emilecantin/ha-eink-calendar/docs/screenshots/Capture d’écran, le 2026-01-17 à 15.30.16.png

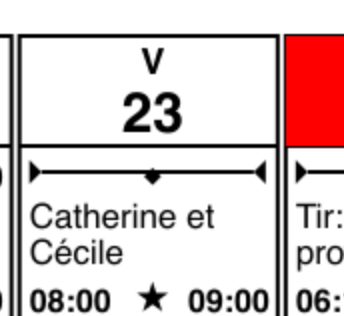
docs/screenshots/Capture d’écran, le 2026-01-17 à 15.30.16.png
