emilecantin/ha-eink-calendar/hardware/battery-carrier/board-top.png

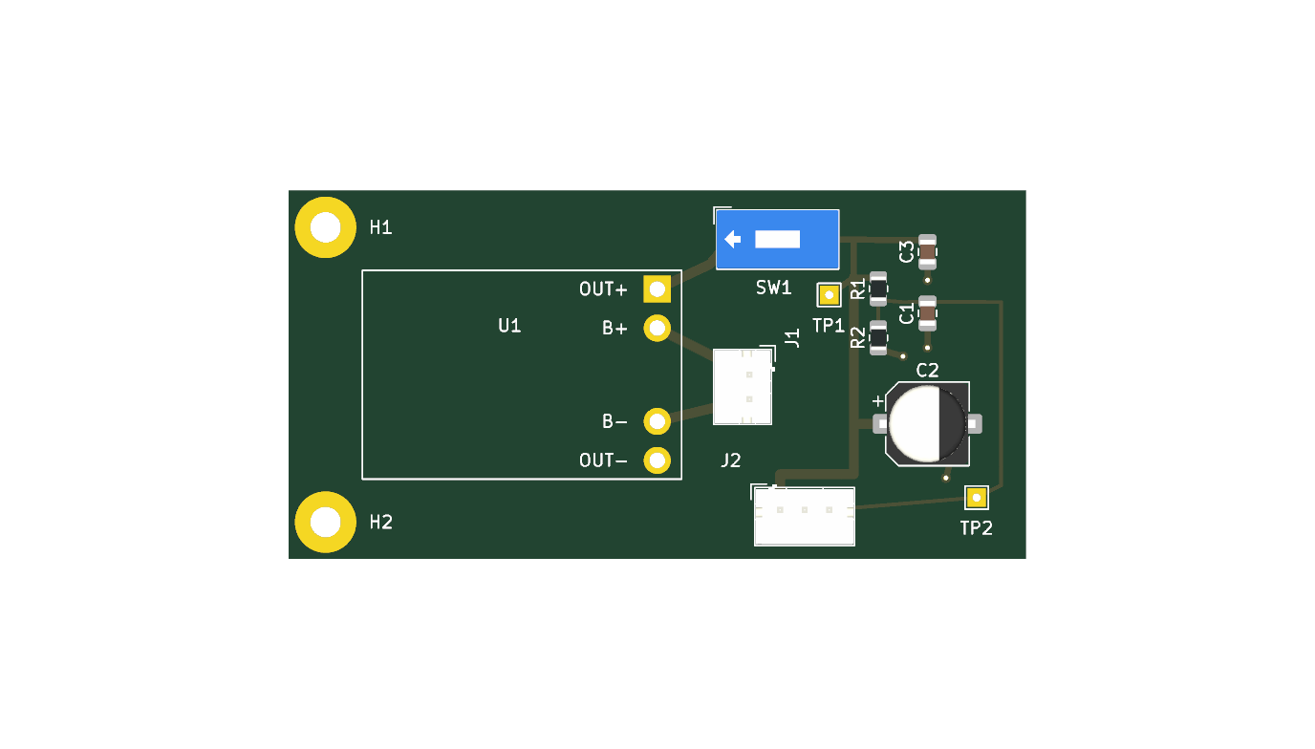
hardware/battery-carrier/board-top.png
