emilecantin/ha-eink-calendar/hardware/battery-carrier/bom.csv

Reference | Value | Footprint
C1 | 100nF | Capacitor_SMD:C_0805_2012Metric
C2 | 220uF 10V | Capacitor_SMD:CP_Elec_6.3x3.9
C3 | 10uF | Capacitor_SMD:C_0805_2012Metric
J1 | 18650 | Connector_JST:JST_PH_B2B-PH-K_1x02_P2.00mm_Vertical
J2 | to ESP32 | Connector_JST:JST_PH_B3B-PH-K_1x03_P2.00mm_Vertical
R1,R2 | 100k 1% | Resistor_SMD:R_0805_2012Metric
SW1 | SPST | Button_Switch_THT:SW_DIP_SPSTx01_Slide_9.78x4.72mm_W7.62mm_P2.54mm
U1 | TP4056 module | epcal:TP4056_Module_03962A
