emilecantin/ha-eink-calendar/hardware/battery-carrier/battery-carrier.kicad_pcb

## KiCad design hardware/battery-carrier/battery-carrier.kicad_pcb (2026-08-29)

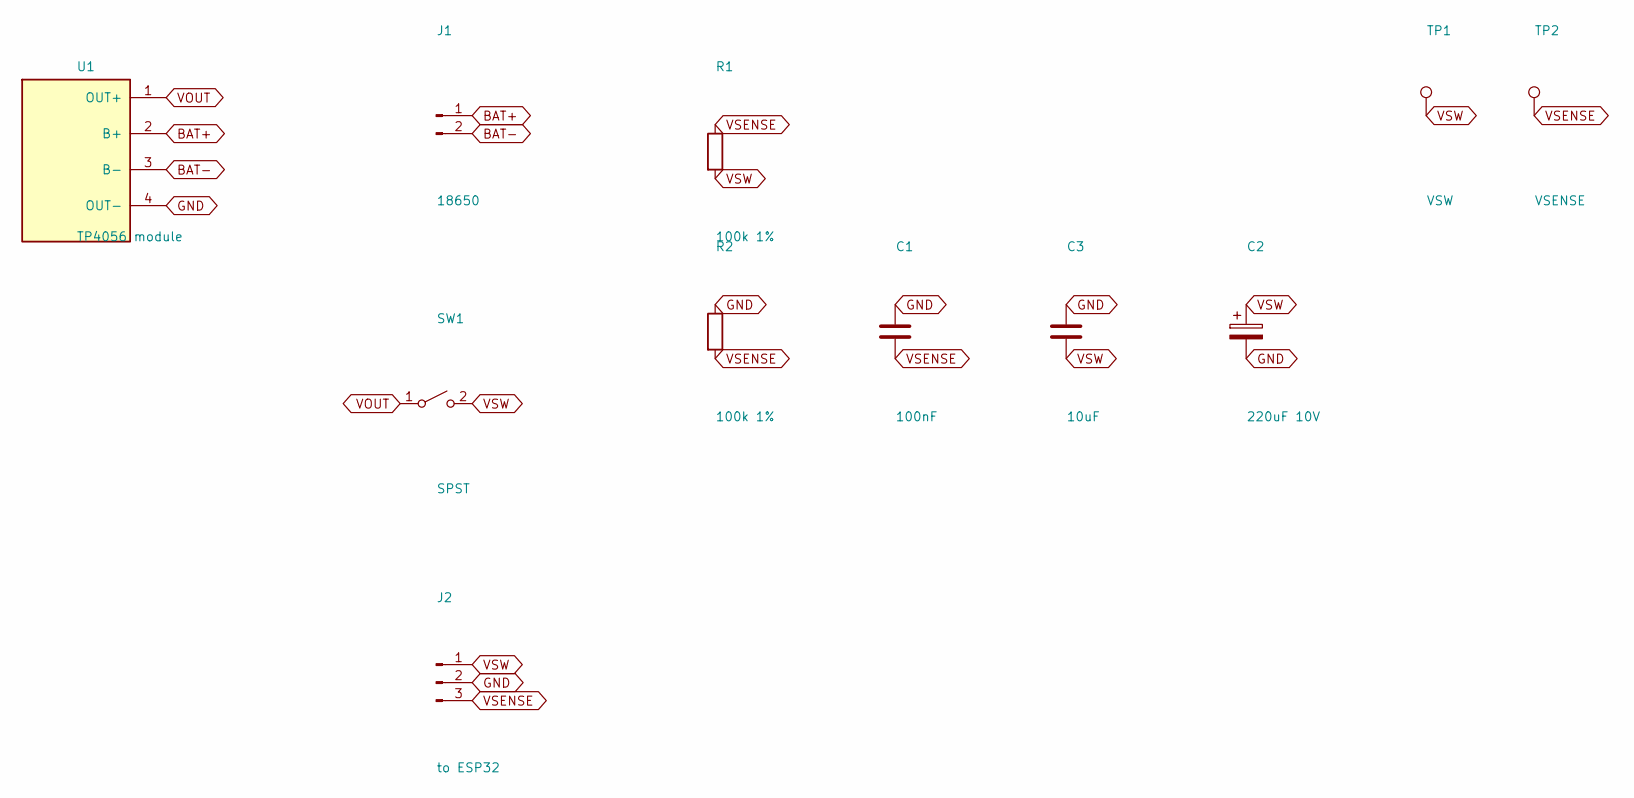
[picture p4: schematic battery-carrier.kicad_sch]

Parts:
C1: 100nF; C_0805_2012Metric
C2: 220uF 10V; CP_Elec_6.3x3.9
C3: 10uF; C_0805_2012Metric
J1: 18650; JST_PH_B2B-PH-K_1x02_P2.00mm_Vertical
J2: to ESP32; JST_PH_B3B-PH-K_1x03_P2.00mm_Vertical
R1, R2: 100k 1%; R_0805_2012Metric
SW1: SPST; SW_DIP_SPSTx01_Slide_9.78x4.72mm_W7.62mm_P2.54mm
TP1: VSW; TestPoint_THTPad_1.5x1.5mm_Drill0.7mm
TP2: VSENSE; TestPoint_THTPad_1.5x1.5mm_Drill0.7mm
U1: TP4056 module; TP4056_Module_03962A

Connections:
BAT+: J1.1, U1.2 (B+)
BAT-: J1.2, U1.3 (B-)
GND: C1.1, C2.2, C3.1, J2.2, R2.1, U1.4 (OUT-)
VOUT: SW1.1 (A), U1.1 (OUT+)
VSENSE: C1.2, J2.3, R1.1, R2.2, TP2.1
VSW: C2.1, C3.2, J2.1, R1.2, SW1.2 (B), TP1.1

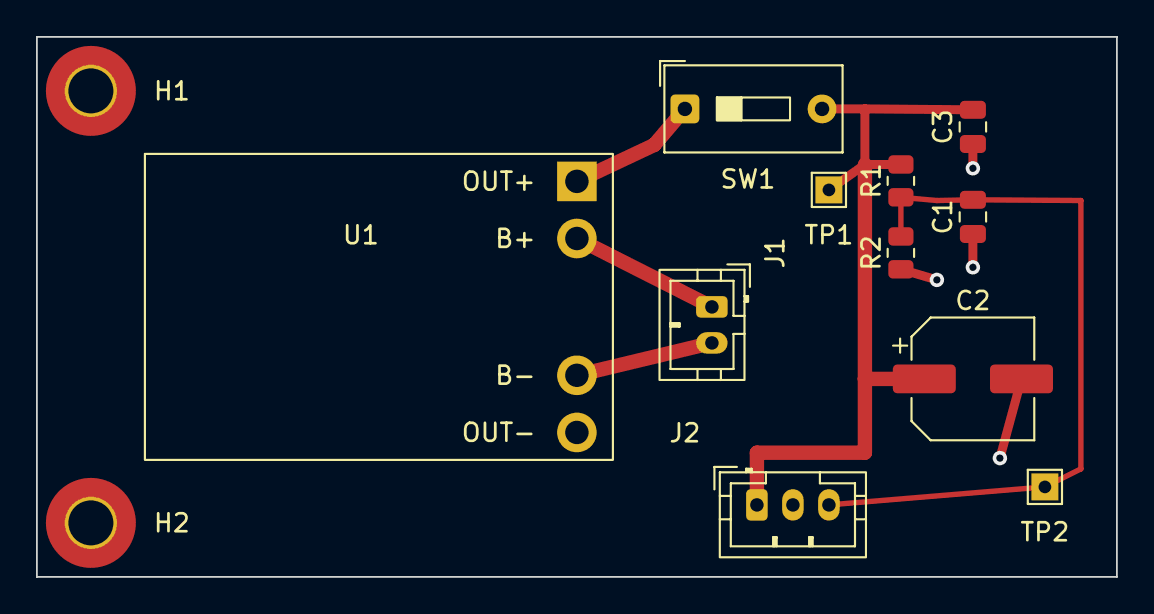
[picture p5: board battery-carrier.kicad_pcb from above]

Board: 2 copper layers, 60.0 x 30.0 mm, 13 parts (0 on the bottom side), 6 nets.

Other parts of the board:
H1, H2: MountingHole_2.5mm_Pad_TopBottom
