emilecantin/ha-eink-calendar/(commit log)

2026-01-18 Initial commit: EPCAL e-paper calendar display
    Features:
    - Node.js server with Home Assistant calendar integration
    - Weather forecast display in headers
    - Canvas-based rendering with Inter font
    - ETag-based caching for battery efficiency
    - ESP32 firmware with WiFiManager for easy setup
    - Pre-rendered QR code setup screen
    - Deep sleep with configurable refresh interval
2026-01-18 Remove old Arduino test files from root folder
    These files were leftovers from early testing, replaced by the
    PlatformIO project structure in Arduino/epcal/.
    [epcal.ino]
2026-01-18 Add Docker support for server deployment
    - Dockerfile with canvas dependencies (cairo, pango)
    - docker-compose.yml with config volume mount
    - Support CONFIG_PATH env var for config file location
    - Update README with Docker setup instructions
    - Add .dockerignore for lean builds
2026-01-18 Add emoji font support to Docker image
    Install fonts-noto-color-emoji for weather icons (☀, ⛅, 🌧, ❄).
2026-01-18 Fix weather icons in Docker: use Symbola font
    - Replace emoji (🌧, 🌫, 💨) with standard Unicode symbols
    - Use Symbola + DejaVu fonts instead of Inter for weather icons
    - Install fonts-symbola and fonts-dejavu-core in Docker image
    Inter font doesn't include weather symbols; Symbola does.
2026-01-19 Add battery testing section to TODO and hardware link to README
    - Added Hardware / Battery Testing section to TODO.md with tasks for
    measuring deep sleep current and optimizing power consumption
    - Added link to Waveshare ESP32 Driver Board wiki in README.md
2026-01-21 Unify event filtering logic across all calendar sections
    Extract common event filtering logic into getEventsForDay() function that:
    - Filters events for a specific day (events starting OR spanning that day)
    - Returns EventForDay objects with startsOnDay/endsOnDay indicators
    Apply this consistently to all sections:
    - Landscape Today section
    - Landscape 6-day section
    - Portrait Today section
    - Portrait Week section
    This ensures multi-day events are displayed correctly in all sections
    with proper start/end markers showing which day they begin and end on.
2026-01-21 Enhance renderer tests with comprehensive coverage
    - Added 6 new test cases for extractChunk function
    - Test all-black and all-white bitmaps
    - Test memory/performance characteristics (zero-copy views)
    - Test ESP32 integration workflow
    - Verify chunk sizes fit ESP32 memory constraints
    - Test horizontal display splitting for proper rendering
    - Total: 15 tests for extractChunk (up from 9)
    - All 86 tests passing across 6 test suites
    - Renderer coverage remains at 4.54% (testing exported functions only)
2026-01-21 Export renderer helper functions for testing
    - Export 8 helper functions from renderer.ts for unit testing:
    - getIconCenterOffset, getIconBottomOffset (icon positioning)
    - getWeatherIcon (weather condition mapping)
    - formatTime (time formatting)
    - truncateText, wrapText (text layout)
    - rotateImageData90CW (image rotation for portrait mode)
    - imageDataTo1Bit (critical bitmap conversion logic)
    - Add comprehensive test suite (43 tests) for newly exported functions:
    - Icon positioning calculations
    - Weather icon mapping with case-insensitivity
    - Time formatting in HH:mm format
    - Text truncation and wrapping with canvas measurement
    - Image rotation (90° clockwise for portr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
2026-01-22 Refactor server rendering code into modular architecture
    - Extract utilities into focused modules:
    - text-utils.ts: Text formatting (truncate, wrap, capitalize, formatTime)
    - weather-utils.ts: Weather icons and forecast handling
    - icon-utils.ts: Collection icon loading, caching, and positioning
    - event-filters.ts: Event filtering and collection icon matching
    - bitmap-utils.ts: Image rotation, 1-bit conversion, chunk extraction
    - font-config.ts: Font registration
    - Create section-renderers directory with dedicated renderers:
    - indicators.ts: Binary sensor indicator bars
    - portrait-today.ts, portrait-week.ts, portrait-upcoming.ts
    - landscape-today.ts, landscape-week.ts, land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
2026-01-28 Add Home Assistant custom component with Python renderer
    - Complete EPCAL integration for Home Assistant
    - Python renderer matching TypeScript output pixel-perfect
    - Support for both portrait and landscape orientations
    - Calendar event rendering with icons, all-day events, multi-day events
    - Weather integration with forecast display
    - Waste collection calendar support
    - Modular section renderers (today, upcoming, week, indicators)
    - Comprehensive test suite with visual regression testing
    - Type checking with Pyright (0 errors, 0 warnings)
    - HTTP endpoints for e-paper display integration
    - Config flow for easy setup in HA UI
2026-01-28 Add Home Assistant test environment to docker-compose
    - Add homeassistant service for integration development
    - Mount custom_components/epcal and ha-test-config
    - Move legacy server to 'legacy' profile (docker-compose --profile legacy up)
    - Add healthcheck for HA service
    - Configure timezone and host network mode
2026-01-28 Update .gitignore for development artifacts
    - Ignore server/epcal-config.json (local config)
    - Ignore server/__tests__/*.js (test files)
    - Ignore server/icons_svg_cache/ (downloaded icons)
    - Ignore Arduino/epcal/setup_screen_preview.png (generated preview)
2026-03-24 Improve ESP32 reliability with watchdog, timeouts, and error display
    - Add hardware watchdog timer (120s) to auto-reboot on hangs
    - Add 10s stall timeout to HTTP download loop
    - Fix DEV_ModuleInit() missing in display_show_error/display_show_message
    - Show error messages on e-paper display for WiFi/HTTP/download failures
    - Clear ETag cache after WiFi reconfiguration to force display refresh
    - Show setup screen when WiFi connection fails (with QR codes)
    - Increase WiFi retries to 5 with 10s timeout per attempt
    - Unify setup screen fonts (all monospaced via Paint library)
    - Add -Wno-error=return-type for Waveshare library build fix
    [display.cpp, epcal.ino, http_client.cpp]
2026-03-24 Rename epcal → eink_calendar and add HA-native device discovery
    Rename the HA domain from epcal to eink_calendar and refactor the
    device setup flow so ESP32s are discovered natively in Home Assistant.
    Directory rename:
    - custom_components/epcal/ → custom_components/eink_calendar/
    - All class names: Epcal* → EinkCalendar*
    - All URLs: /api/epcal/ → /api/eink_calendar/
    - Display names: "EPCAL" → "E-Ink Calendar"
    New device discovery architecture:
    - ESP32 discovers HA via mDNS (_home-assistant._tcp)
    - POST /api/eink_calendar/announce triggers config_entries discovery flow
    - "Discovered" card appears in Settings → Integrations
    - User configures calendars/weather/layout in the config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
2026-03-24 Register announce endpoint at integration load time
    The HTTP views were only registered when a config entry existed,
    meaning the announce endpoint returned 404 for new devices with
    no config entries yet. Now registers views in async_setup() which
    runs when the integration loads, before any config entries.
    Also fix display_sleep() GPIO errors by re-initializing pins.
    [display.cpp]
2026-03-24 Add zeroconf discovery for automatic HA integration loading
    The integration wasn't loading because HA only loads integrations
    that have config entries. Now the ESP32 advertises a _eink-calendar._tcp
    mDNS service, and HA's zeroconf auto-discovers it, loading the
    integration and registering the announce endpoint automatically.
2026-03-24 Fix bitmap inversion, mDNS timing, and config flow title
    - bitmap_utils: Fix inverted bit logic (0=colored, 1=white per e-paper spec)
    - bitmap_utils: Fix thresholds to match Node.js reference renderer
    - epcal.ino: Advertise mDNS service right after WiFi connects
    - config_flow: Fix missing {name} placeholder in configure step title
    - manifest: Rename to "E-Ink Calendar", bump to 0.1.4
    [epcal.ino]
2026-03-24 Replace pre-generated icon PNGs with MDI webfont rendering
    Use the MDI TTF webfont (1.2MB, 7448 icons) instead of 137 pre-generated
    PNGs. Icons are now rendered as font glyphs at native target sizes via
    Pillow's ImageFont, giving crisp 1-bit output at any size. Also fixes
    calendar icon resolution to check HA entity registry, adds 60s retry on
    download failure, and improves mDNS advertisement timing.
    [epcal.ino]
2026-03-25 Fix stretched icons by centering glyphs instead of resizing
    Font glyphs aren't always square — the resize to (size, size) was
    stretching non-square glyphs. Now renders at natural size and centers
    in a square canvas.
2026-03-25 Add Last Check-in sensor to track ESP32 connectivity
    Records a timestamp every time the ESP32 hits the announce, bitmap, or
    ETag check endpoints. Exposes it as a "Last Check-in" timestamp sensor
    on the device. This can be used to detect offline devices when check-ins
    stop arriving.
2026-03-25 Cache rendered calendar across camera and bitmap views
    Unify rendering so render_calendar() produces bitmap layers and PNG
    preview in one pass. Coordinator caches the result and serves it to
    both the camera entity and bitmap HTTP view, eliminating redundant
    renders (previously 4+ per ESP32 refresh cycle).
    Also use rendered.etag (content hash) instead of timestamp-based ETag,
    and add per-MAC 60s rate limiting on the unauthenticated announce endpoint.
2026-03-25 Separate waste events from regular calendar, add icon config, and fixes
    - Completely separate waste collection events from regular calendar events
    throughout the rendering pipeline (no more merging)
    - Add two-step options flow: waste calendars now get an icon picker per
    event type (Ordures, Recyclage, Compost, etc.) fetched from actual
    calendar data
    - Fix weather entity missing after HA restart (extend retry logic)
    - Shorten overflow indicator to "+ N autres" to prevent text overflow
    - Bump version to 0.1.11
2026-03-25 Fix weather display and pre-render on coordinator update
    - Fall back to current conditions when forecast has no entry for today
    - Pre-render calendar during coordinator update so previews load instantly
    - Preserve existing options when saving options flow
    - Add debug logging for weather data fetching
    - Bump version to 0.1.13
2026-03-27 Reliability improvements, configurable language, and test infrastructure
    - Remove periodic polling; ESP32 check-in triggers fresh data fetch
    - Pre-render bitmaps in coordinator for instant serving
    - Fail explicitly with UpdateFailed when data sources aren't ready
    - Invalidate render cache on trigger_render service call
    - Propagate refresh_interval to ESP32 via X-Refresh-Interval header
    - Add configurable language setting (French/English) with i18n module
    - Replace fragile locale.setlocale with translation maps
    - Fix test infrastructure: remove tests/__init__.py, add conftest.py
    with sys.path setup, convert all tests to direct imports
    - Add run_tests.sh for easy test execution
    - Add new tes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
    [epcal.ino, http_client.cpp, http_client.h]
2026-03-27 Update documentation and remove migration-era artifacts
    - Rewrite root README with current architecture, config options, API
    endpoints, and development instructions
    - Rewrite custom component README with up-to-date settings table
    - Rewrite docs/TESTING.md for the new run_tests.sh workflow
    - Remove PROJECT_STRUCTURE.md (stale)
    - Remove docs/BORDER_FIX_RESULTS.md (TS→Python migration artifact)
    - Remove docs/archive/ with old visual test output PNGs
    - Remove scripts/ (old TS↔Python comparison scripts)
    - Remove tests/ at root (old migration-era test infrastructure)
    - Add .venv/ and visual_output/ to .gitignore
2026-03-27 Fix stale ETag causing ESP32 display to never update
    When _async_update_data() raised UpdateFailed after startup (e.g.,
    calendar service temporarily unavailable), the coordinator kept stale
    data and ETag. The /check endpoint returned 304 Not Modified, so the
    ESP32 never downloaded new bitmaps.
    - Only raise UpdateFailed on first refresh (startup); log warnings on
    subsequent failures and render with available data
    - Add diagnostic logging to /check endpoint (ETag comparison, refresh
    failure detection)
    - Bump version to 0.1.18
2026-03-27 Add WARNING-level diagnostic logging for ESP32 communication
    The INFO-level check logs weren't visible. Bump all diagnostic logs
    to WARNING so they appear in default HA log view:
    - Announce handler: log MAC and entry_id on each configured response
    - Bitmap handler: log every request (entry_id + layer) at entry
    - Unknown entry_id: log before returning 404
    - Check ETag comparison: bumped to WARNING
2026-03-27 Fix display crash after WiFi downloads and enable OTA partitions
    Two firmware changes that require a USB flash:
    1. Fix ESP32 crash after bitmap download: WiFi operations reset
    SPI/GPIO pins. display_send_* and display_refresh used SPI without
    re-initializing, causing crashes. The ESP32 rebooted every ~27s
    re-downloading the same bitmaps. Add DEV_ModuleInit() before all
    display operations (matching existing pattern in display_sleep and
    display_show_message).
    2. Switch partition scheme from huge_app.csv (3MB, no OTA) to
    min_spiffs.csv (1.87MB x2, OTA capable). Firmware is 1.33MB
    (67% of slot). This enables future over-the-air updates.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
    [display.cpp]
2026-03-27 Add firmware binary storage and serving endpoint for OTA updates
    Add FirmwareManager module for storing firmware binaries with version
    tracking. New HTTP endpoint serves firmware to ESP32 devices with
    MAC-based auth. New upload_firmware service allows uploading .bin files
    with version metadata.
    - GET /api/eink_calendar/firmware/{entry_id} — serve firmware binary
    - upload_firmware service — store firmware from local file path
    - FirmwareManager — handles storage, version sidecar, update checks
    - 10 unit tests for FirmwareManager
2026-03-27 Add OTA metadata to announce protocol for firmware updates
    When an ESP32 announces with an outdated firmware version, the HA
    announce response now includes a firmware_update field with version,
    download URL, and size. The ESP32 parses and logs this info (actual
    OTA download/flash will be implemented in a follow-up unit).
2026-03-27 Implement ESP32 OTA download and upgrade /check to JSON sync protocol
    The /check endpoint is now the single sync point: ESP sends ETag +
    firmware version, HA returns 304 (nothing to do) or 200 with JSON
    describing what changed (new etag, refresh_interval, firmware_update).
    ESP32 changes:
    - Add http_ota_update() with streaming 4KB buffer, watchdog resets,
    stall detection, and connection loss handling
    - Parse JSON from /check response for OTA info
    - Apply OTA before bitmap download; graceful fallback on failure
    - Bump FIRMWARE_VERSION to 1.1.0
    HA changes:
    - /check endpoint returns JSON body on 200 (etag, refresh_interval,
    firmware_update) instead of ETag/X-Refresh-Interval headers
    - Fix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
    [epcal.ino, http_client.cpp, http_client.h]
2026-03-27 Add firmware version sensor and downgrade diagnostic logs
    - Add EinkCalendarFirmwareVersionSensor showing the ESP32's firmware
    version (reported via announce endpoint)
    - Coordinator tracks firmware version via record_checkin() to avoid
    double listener notification
    - Downgrade 3 diagnostic _LOGGER.warning calls to debug in http_views
    - Improve test infrastructure: fake HA base classes in conftest.py
    so tests can instantiate real integration classes
2026-03-27 Fix display update, add force refresh button, bundle firmware with integration
    Display fix:
    - Remove DEV_ModuleInit() from display_send_*/refresh/sleep — it pulls RST
    low, destroying display controller state between data transfers
    - Download all bitmap chunks to SPIFFS first, then init display and send
    atomically (no WiFi interference during display operations)
    - Custom partition table: 1.5MB OTA app slots + 384KB SPIFFS for chunk staging
    Force refresh:
    - Add "Force Refresh" button entity on the device page
    - Pressing it queues a forced re-download on the next ESP32 check-in
    (bypasses ETag match)
    - trigger_render service also forces refresh
    Sensor improvements:
    - "Last Update" sens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
    [partitions.csv]
2026-03-27 Fix OTA stack overflow crash loop
    Increase Arduino loop task stack from 8KB to 16KB to prevent stack
    overflow during HTTPS OTA downloads. Add RTC-persisted retry counter
    that skips OTA after 3 consecutive failures, breaking the infinite
    crash-reboot cycle.
    Firmware 1.1.2, integration 0.3.1.
    [epcal.ino]
2026-03-27 Fix firmware version not reported on check-in
    The check endpoint read X-Firmware-Version from the header but never
    passed it to coordinator.record_checkin(), leaving the firmware version
    sensor stuck on "unknown".
2026-03-27 Switch from SPIFFS to LittleFS for bitmap staging
    SPIFFS overhead left insufficient usable space for 4×80KB bitmap chunks
    in the 384KB partition. LittleFS is a drop-in replacement with less
    overhead.
    Firmware 1.1.3, integration 0.3.3.
    [epcal.ino]
2026-03-27 Prevent OTA downgrades by comparing semver properly
    The firmware manager used simple inequality to check for updates,
    which would push older firmware to devices running newer versions.
    Now uses semver comparison so OTA only triggers when bundled > device.
2026-03-27 Update docs for OTA, LittleFS, and force refresh changes
    [partitions.csv]
2026-03-27 Only record check-in on /check endpoint, not every bitmap request
    record_checkin() was called on every bitmap layer request (5 times per
    wake cycle), causing rapid sensor updates. Now only called once on the
    check endpoint.
2026-03-27 Only write sensor/camera state when value actually changes
    All sensor and camera entities were calling async_write_ha_state() on
    every coordinator update, even when their values hadn't changed. This
    caused hundreds of spurious state history entries from unrelated
    coordinator refreshes (e.g., image entity polling).
2026-03-27 Decouple check-in sensors from coordinator update cycle
    Check-in and firmware version sensors now use a dedicated on_checkin()
    callback instead of the coordinator's generic listener. record_checkin()
    no longer broadcasts async_set_updated_data — it only notifies check-in
    subscribers.
    Last image change sensor stays on the coordinator listener (it depends
    on render data) but only writes state when the value changes.
2026-03-28 Device status sensor, diagnostics, error reporting, and ETag fix
    - Add device status state machine (healthy/rapid_checkin/overdue/error)
    with rolling window median interval detection for rapid check-in
    - Add diagnostic sensors: device ETag, check-in count, device status
    - Add error reporting endpoint (POST /api/eink_calendar/error/{entry_id})
    - ESP32: report errors on failure paths (check, download, display, LittleFS)
    - ESP32: re-announce if error endpoint missing (auto-upgrade existing devices)
    - Fix ETag not persisting: save cache after download, before display refresh
    - Fix blocking I/O: cache firmware info at init instead of reading each call
    - Improve logging: ETag comparison and bitm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
    [config.cpp, config.h, epcal.ino, http_client.cpp, http_client.h]
2026-03-28 Add updating_firmware device status state
    When HA serves firmware to the ESP32, device status changes to
    "updating_firmware" so it's clear the device is mid-OTA rather than
    overdue or unhealthy. Clears on next check-in.
2026-03-28 Fix null-termination after strncpy in ESP32 firmware
    strncpy does not null-terminate when the source string is longer than
    the destination buffer. This adds explicit null-termination after every
    strncpy call that was missing it (15 call sites across http_client.cpp
    and epcal.ino). Also switches struct initialization to aggregate `= {}`
    for AnnounceResponse and FetchResponse to guarantee zero-initialized
    buffers, eliminating a class of bugs where unset fields contained
    stack garbage.
    Closes #17
    [epcal.ino, http_client.cpp]
2026-03-28 Add native test environment for ESP32 firmware unit tests
    Set up PlatformIO native test infrastructure so firmware logic can be
    tested on the host machine without flashing hardware. Includes:
    - [env:native] in platformio.ini with Unity test framework
    - Minimal stubs for Arduino.h, WiFi.h, HTTPClient.h, Preferences.h,
    Update.h, and esp_task_wdt.h in test/stubs/
    - Initial test suite (test/test_native/test_structs.cpp) covering:
    - Config/CacheState/BitmapEndpoints struct zero-initialization
    - Buffer size validation for all char[] fields
    - strncpy null-termination patterns (regression test for #17)
    - Display constants and chunk buffer size calculation
    - Enum value stability for Fetc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
2026-03-28 Add integration test infrastructure for HA custom component
    Set up Docker-based integration testing against a real Home Assistant instance:
    - docker-compose.test.yml: HA on port 18123 with component mounted
    - Test runner script with --start-ha flag for CI use
    - pytest + aiohttp integration tests for announce, bitmap, and error APIs
    - Tests auto-skip when HA is not reachable (pytest marker)
    - Tests requiring config entry creation skip when HA_TOKEN is not set
    Closes #31
2026-03-28 Fix misleading config.configured flag set on non-configured states
    The configured flag was set to true on ANNOUNCE_PENDING,
    ANNOUNCE_NOT_INSTALLED, promptForHaUrl, and saveParamsCallback —
    none of which mean the device is actually configured by HA. This
    could cause stale/incorrect state to persist in NVS.
    Now only set config.configured = true when announce returns
    ANNOUNCE_CONFIGURED, accurately reflecting the device state.
    Closes #18
    [epcal.ino]
2026-03-28 Optimize image_to_1bit with NumPy vectorized operations
    Replace per-pixel Python loop (1.3M iterations) with NumPy array
    operations for ~100x speedup on Raspberry Pi. The function now
    converts the PIL image to a NumPy array, computes boolean masks
    vectorized, and packs bits with np.packbits.
    Fixes #4
2026-03-28 Use ArduinoJson for announce payload instead of string concatenation
    Replace fragile string concatenation with JsonDocument + serializeJson()
    to eliminate injection risk if values ever contain quotes. This matches
    the pattern already used in http_report_error().
    Fixes #19
    [http_client.cpp]
2026-03-28 ESP32 low-priority cleanup: TLS state, dead code, duplicate routes, mDNS retry
    - Reset TLS/TCP client state before reuse in httpBegin() to prevent stale
    connection failures (#18)
    - Remove unused setup_screen.h — QR codes are generated at runtime (#27)
    - Remove duplicate /connecttest.txt route registration (#28)
    - Add mDNS discovery retry (3 attempts, 1s delay) for flaky networks (#29)
    - Expand comments for -Wno-error=return-type Waveshare workaround (#31)
    - Document lib_extra_dirs hardcoded path dependency (#32)
    Closes #21
    [epcal.ino, http_client.cpp]
2026-03-28 Add URL validation to ESP32 web form input
    Validate HA URLs on the ESP32 config forms (WiFiManager params page
    and the manual URL entry form) to reject invalid input early instead
    of causing confusing HTTP failures on every boot cycle.
    Validation rules: must start with http:// or https://, max 127 chars,
    no whitespace. Applied server-side in both form handlers, plus
    client-side JS validation on the manual entry form.
    Closes #20
    [epcal.ino, url_validation.h]
2026-03-28 Add 'important' event support in upcoming section
    Events with a '!' prefix in their title now bypass the multi-day/all-day
    filter in the upcoming section. The prefix is stripped for display, and
    important events get a red accent bar. Extracted filter logic into a
    testable `filter_upcoming_events()` function.
    Closes #13
2026-03-28 Add regression tests for merged PRs #46, #33/#17, #47, #38, #51
    - #46: Verify MDI_TO_UNICODE imports from renderer.const, not integration const
    - #33/#17: Add buffer-boundary strncpy tests (source exactly fills buffer)
    - #47: Test ArduinoJson announce/error payload serialization and roundtrip
    - #38: Verify zero-initialized Config has configured == false
    - #51: Verify announce status enum completeness for retry logic
    - Add ArduinoJson lib_dep to native test environment
2026-03-28 Fix timed events ending at midnight bleeding into next day
    - Use strict > comparison for timed events in get_events_for_day,
    so events ending exactly at 00:00 don't appear in the next day
    - Keep >= for all-day events (inclusive end dates after adjustment)
    - Capture overflow count before truncation instead of re-filtering
2026-03-28 Encapsulate coordinator internals and fix callback lifecycle
    - on_checkin() returns removal callable; uses set to prevent duplicates
    - All sensors register cleanup via async_on_remove(), fixing memory leak
    - Add consume_force_refresh() to replace direct _force_refresh access
    - record_device_error() fires callbacks internally; error view no longer
    reaches into private _checkin_callbacks
2026-03-28 Fix stale display: save ETag only after successful display refresh
    The ESP32 was saving the ETag to NVS before display refresh. If the
    display refresh failed or crashed, subsequent check-ins would get 304
    (ETag matches) and the display would never retry — resulting in a
    permanently stale image.
    Move cache_save() to after display_refresh() succeeds, so a failed
    refresh forces a re-download on the next boot cycle.
    Adds 4 cache state invariant tests documenting the correct sequence.
    [epcal.ino]
2026-03-28 Add display sleep guard, refresh interval floor, and fix double getDeviceMac
    - Track display initialization state; display_sleep() is now a no-op if
    the display was never initialized, preventing SPI commands to
    uninitialized hardware
    - Floor refresh_interval at 1 minute to prevent infinite reboot loops
    if server sends 0
    - Cache getDeviceMac() in a local variable instead of calling it twice
    [display.cpp, display.h, epcal.ino]
2026-03-28 Remove unreachable max() floor in updateCalendar and fix refresh interval tests
    The > 0 guard in updateCalendar already excludes zero, making the
    max(..., 1) floor unreachable. Remove it and add a clarifying comment.
    Update refresh interval tests to separately cover tryAnnounce (which
    still needs the floor) and updateCalendar (which relies on the > 0 guard).
    [epcal.ino]
2026-03-28 Fix TLS client reuse, move OTA buffer to heap, use actual chunk size for writes
    - Only stop the previously-used HTTP client (plain or secure) instead
    of stopping both on every request
    - Move 4KB OTA buffer from stack to heap to reduce stack pressure
    - Use resp.bytes_read for LittleFS writes instead of hardcoded
    CHUNK_BUFFER_SIZE, with validation warning if sizes differ
    [epcal.ino, http_client.cpp, http_client.h]
2026-03-28 Fix PR review items: stop both TLS clients and treat chunk size mismatch as error
    Revert httpBegin to always stop both secureClient and plainClient
    before beginning a new request — the microsecond cost is negligible
    on a device that deep-sleeps for 15+ minutes.
    Promote chunk size mismatch from a warning to a hard error that
    aborts the download loop, since a short bitmap cannot be displayed
    correctly.
    [epcal.ino, http_client.cpp]
2026-03-30 Shut down WiFi before display refresh to reduce power draw
    The 37-second tri-color refresh is the most power-hungry operation.
    Running it with the radio active can cause brownout on marginal supplies.
    WiFi is disconnected after bitmap downloads complete, before display_init().
    Firmware 1.2.1.
    [epcal.ino]
2026-08-03 Add boot diagnostics to explain rapid_checkin reboot loops
    rapid_checkin is a derived HA status, not a firmware state: it means the
    median check-in interval is under half refresh_interval, so it is always a
    symptom of the ESP32 rebooting on a short-sleep path. Until now there was no
    way to tell which one.
    The blind spot was the window after updateCalendar() shuts down WiFi for the
    display refresh. Anything failing there -- including a brownout or watchdog
    during the 37s refresh -- could never report itself. And because cache_save()
    only runs after a successful refresh, the ETag is never persisted, so the
    device re-downloads and retries forever.
    Firmware:
    - diagnostics.h: BootStage enum plu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
2026-08-29 Bump to v0.5.0 (firmware 1.3.1)
    Boot diagnostics for rapid_checkin reboot loops: RTC stage markers,
    deferred error reporting, and the HA-side device status attributes.
    Note: v0.4.1 was tagged with manifest still at 0.4.0; this bump moves
    the manifest to 0.5.0 so the released tag and manifest agree again.
2026-08-29 Add battery-carrier PCB for the TP4056 module
    Carrier board for the existing TP4056 charging module (marking 03962A):
    battery-sense divider, JST connectors, power switch, bulk decoupling.
    The module's pad geometry was measured rather than assumed — two tight
    1/8" pairs with a wide middle gap (3.175 / 7.600 / 3.175 mm, span 13.950).
    Drills are oversized to 1.3 mm so the residual +/-0.05 mm uncertainty in the
    middle pitch cannot cause a fit failure. DESIGN.md records the three
    independent measurement routes and why they initially disagreed.
    The board is generated from gen_footprint.py / gen_sch.py / gen_board.py;
    regeneration commands are in DESIGN.md. Verifies clean: 0 DRC, 0 unconnected,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
2026-08-29 Ignore server/.env
    It sits alongside the other server/ config files that are already ignored,
    and holds credentials — a `git add -A` would otherwise commit it.
2026-08-30 Let HA command the check-in interval dynamically
    The transport already existed — HA sends the interval on every check response
    (X-Refresh-Interval on a 304, refresh_interval in the body on a 200) and the
    firmware applies it. Only the value was static, read straight from the config
    option. This makes it computed.
    Policy (interval_policy.py, kept free of HA imports so it unit-tests in
    isolation): effective = base x (multiplier inside quiet hours else 1), clamped
    to 1..1440. The base is a RestoreNumber entity so automations can move it;
    quiet hours are configurable and wrap midnight. The multiplier is floored at 1
    so a quiet period can only slow check-ins down, never speed them up.
    Two thin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
